Kokuko3/Swashplateless-heli-control/README.md

# Swashplateless-heli-control

This repository outlines the work completed across a two semester Independent Study in accordance with Wright State University Departmental Honor's requirements.

The white paper and presentation included were presented as a compilation of the study.
