Kokuko3/Swashplateless-heli-control/3D prints/Individual STL's/motor_mount_new.stl

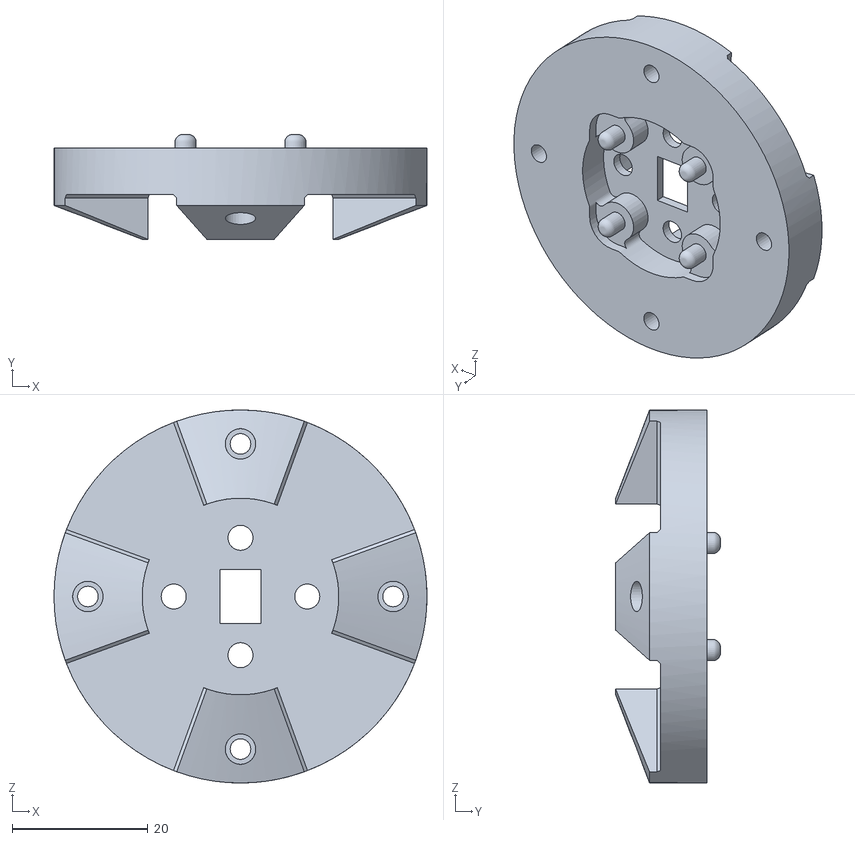
[picture p3: CAD file, 2025-04-25]
3D prints/Individual STL's/motor_mount_new.stl
55.0 x 15.5 x 55.0
