Kokuko3/Swashplateless-heli-control/3D prints/Individual STL's/props.stl

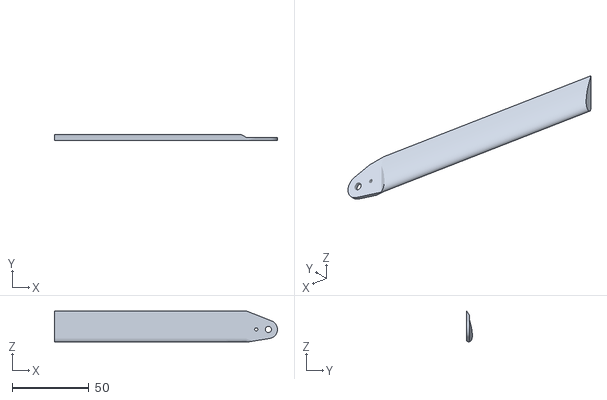
[picture p4: CAD file, 2025-03-29]
3D prints/Individual STL's/props.stl
145.1 x 3.73 x 20.2
