Kokuko3/Swashplateless-heli-control/3D prints/Individual STL's/magnet_gluing_jig.stl

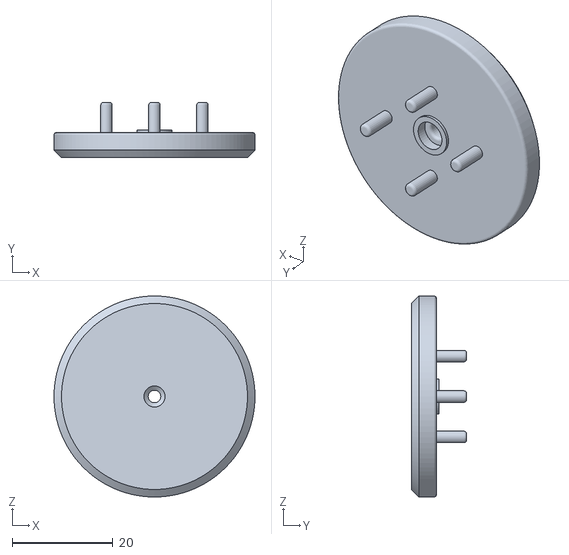
[picture p5: CAD file, 2025-03-18]
3D prints/Individual STL's/magnet_gluing_jig.stl
40.0 x 11.0 x 40.0
