Kokuko3/Swashplateless-heli-control/3D prints/Individual STL's/motor_mount.stl

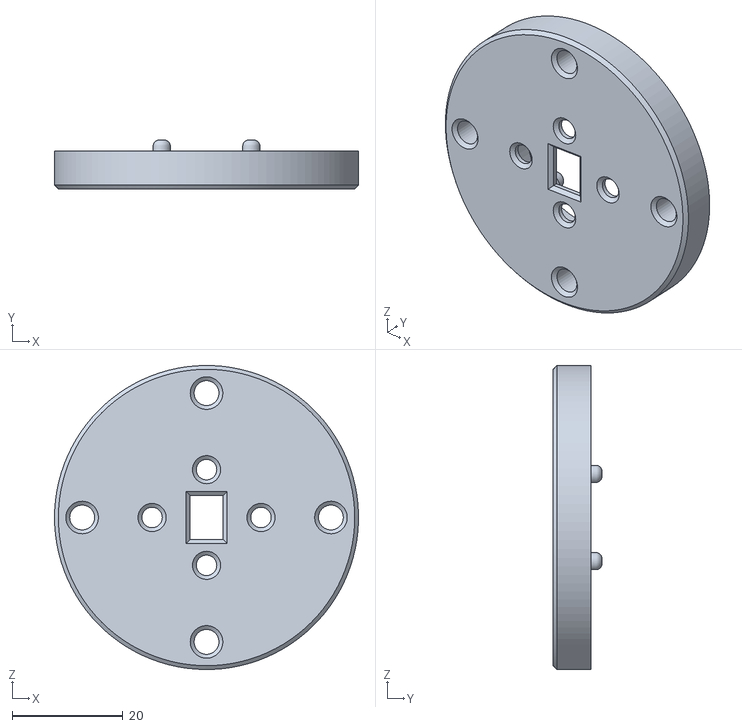
[picture p6: CAD file, 2025-03-09]
3D prints/Individual STL's/motor_mount.stl
55.0 x 8.85 x 55.0
