Kokuko3/Swashplateless-heli-control/3D prints/Individual STL's/hinge.stl

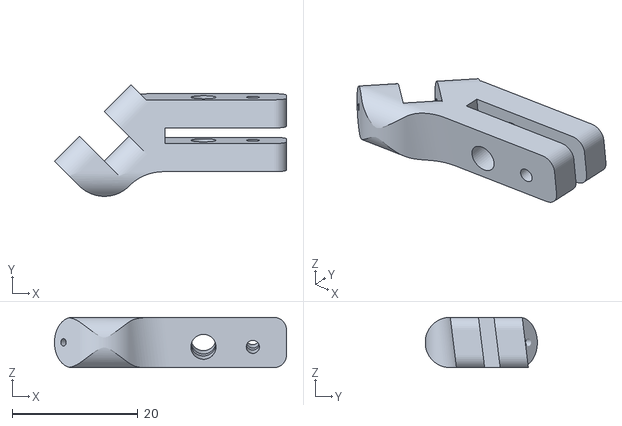
[picture p7: CAD file, 2025-03-09]
3D prints/Individual STL's/hinge.stl
36.9 x 17.8 x 8.00
