Kokuko3/Swashplateless-heli-control/3D prints/Individual STL's/teeter.stl

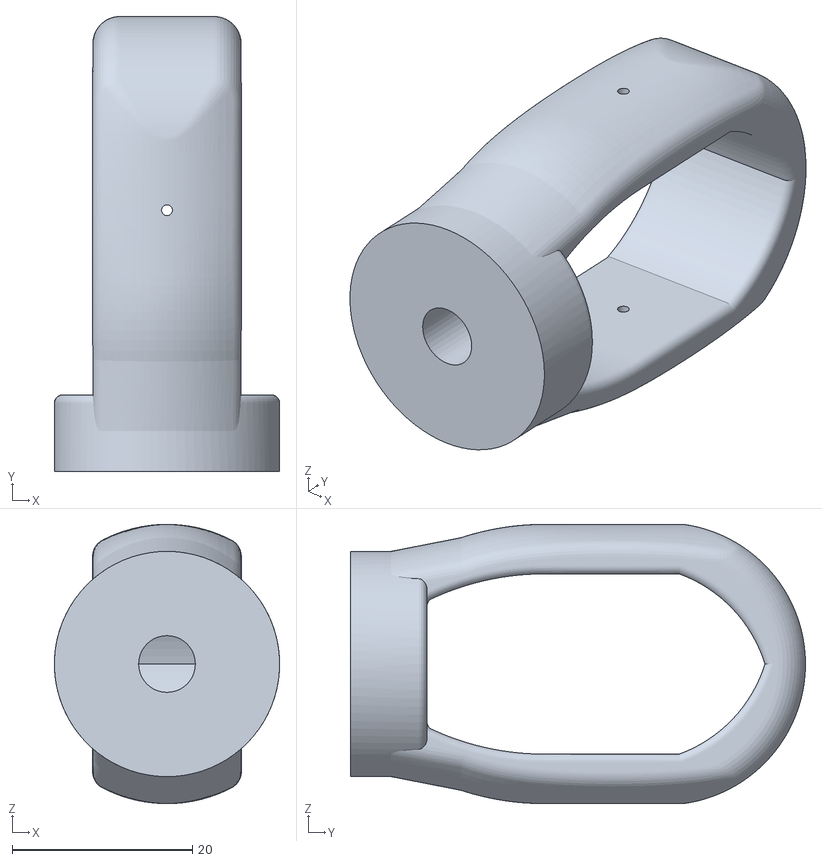
[picture p8: CAD file, 2025-03-09]
3D prints/Individual STL's/teeter.stl
25.0 x 50.5 x 31.0
