Kokuko3/Swashplateless-heli-control/3D prints/Individual STL's/hall_effect_mount.stl

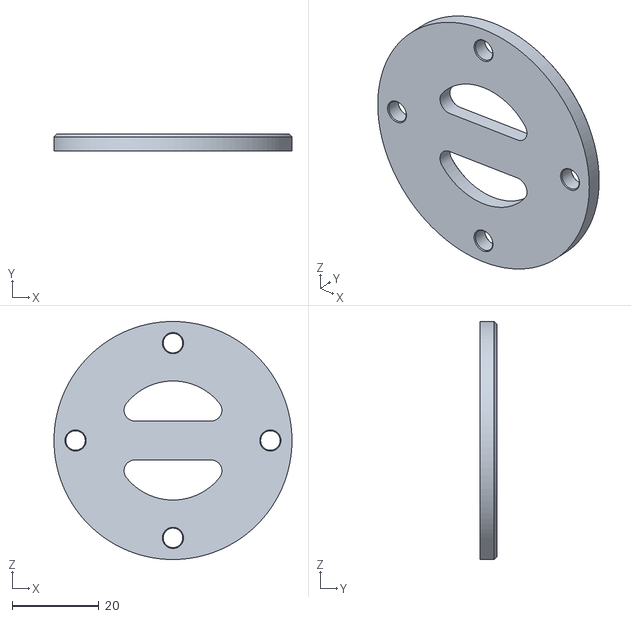
[picture p9: CAD file, 2025-03-09]
3D prints/Individual STL's/hall_effect_mount.stl
55.0 x 4.00 x 55.0
