Kokuko3/Swashplateless-heli-control/3D prints/Individual STL's/center.stl

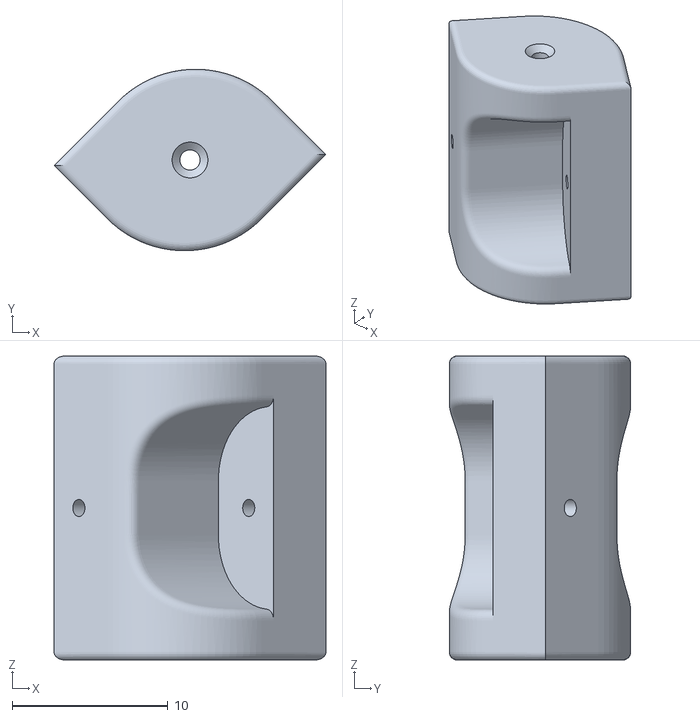
[picture p10: CAD file, 2025-03-09]
3D prints/Individual STL's/center.stl
17.4 x 11.6 x 19.5
