Kokuko3/Swashplateless-heli-control/3D prints/Individual STL's/load_cell_mount.stl

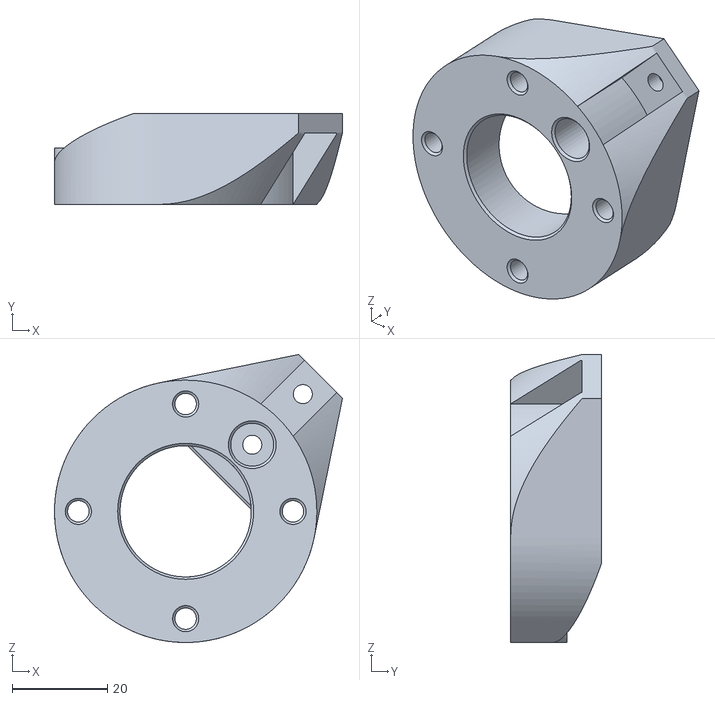
[picture p11: CAD file, 2025-03-09]
3D prints/Individual STL's/load_cell_mount.stl
60.4 x 19.0 x 60.4
