Kokuko3/Swashplateless-heli-control/(list of files, cad)

Other CAD files:
3D prints/Individual STL's/prop_right.stl
3D prints/Fusion360 Models/Magnet glueing jig v6.f3d
3D prints/Fusion360 Models/Motor Mount v2 v47.f3d
3D prints/Fusion360 Models/Rotor v2 v8.f3z
