Kokuko3/Swashplateless-heli-control/Diagrams/Hardware Block Diagram .pdf

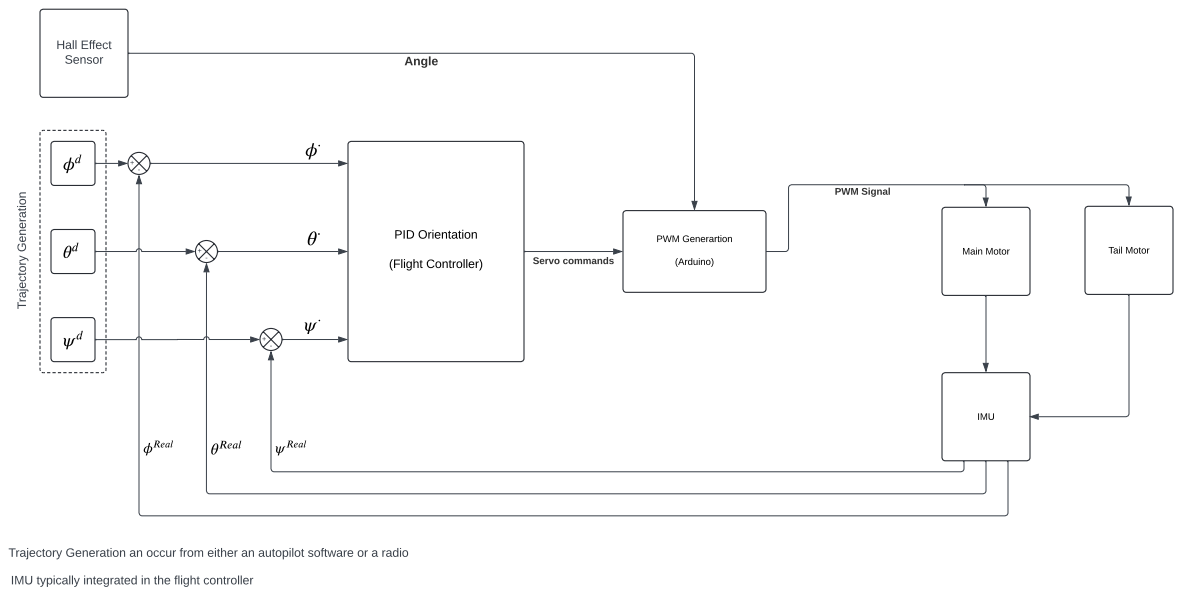
[picture p12: page 1]
Process; PID Orientation; (Flight Controller); Servo commands; PWM Generartion; (Arduino); PWM Signal; Main Motor; Angle; Hall Effect Sensor; IMU; - Tail Motor

Trajectory Generation an occur from either an autopilot software or a radio

IMU typically integrated in the flight controller
