Kokuko3/Swashplateless-heli-control/(threads)

Thread 1 (2025-01-16):

Pipe motor signal from FC to Arduino

Kokuko3, 2025-01-16:
Configure a digital read and write to and from the Arduino. Just setup to echo the throttle value from the flight controller to the arduino

Closed 2025-05-28.
