Kokuko3/Swashplateless-heli-control/(commit log)

2024-09-29 add arduino_shield
    [arduino_shield.kicad_pcb, arduino_shield.kicad_sch]
2024-10-08 Added Block diagram andpaper on PID Tuning with NN
    [arduino_shield.kicad_pcb, arduino_shield.kicad_sch]
2025-01-24 ESC Calibration should be correct now
2025-02-07 Changed the PWM clock frequency to 4KHz
2025-03-08 Commit new files
    [Magnet glueing jig v6.f3d, Motor Mount v2 v47.f3d]
2025-03-09 Uploaded STL's for 3D printing
    [Magnet glueing jig v6.f3d, Magnet glueing jig v6.stl, Motor Mount (1).stl, Motor Mount v2 v47.f3d, Rotor v2 v8.f3z, center.stl, hall effect mount.stl, hinge_left.stl]
2025-03-18 Updated 3D prints
    [Magnet glueing jig v6.f3d, Magnet glueing jig v6.stl, Motor Mount v2 v47.f3d, Rotor v2 v8.f3z, center.stl, hall_effect_mount.stl, hinge.stl, hinge_left.stl]
2025-03-27 Adding Props for 3D printing
    [prop_left.stl, prop_right.stl, props.3mf]
2025-03-29 Some updates
    [Rotor v2 v1.step, Rotor_mount.3mf]
2025-04-06 New fix
    [Rotor v2 v1.step, Rotor_mount.3mf, props.3mf]
2025-04-14 Data plotting script to show values
    [full_pitch.csv, half_pitch.csv, zero_pitch.csv]
2025-04-25 Digital control works
    Maybe timing? Seems like we can't get the motor to update faster than it spins
    [Motor Mount.stl, Rotor_mount.3mf, props.3mf]
2025-05-06 Cleaning up the repo
    Renaming some stuff and cleaning up the repo for future use
    [Magnet glueing jig v6.f3d, Motor Mount v2 v47.f3d, Rotor v2 v8.f3z, center.stl, full_pitch.csv, half_pitch.csv, hall_effect_mount.stl, hinge.stl]
